craigyjp/Polyphonic-6-note-MIDI-to-CV/Schematic_MIDI-CV_2021-04-22.pdf

# Teensy 3.6

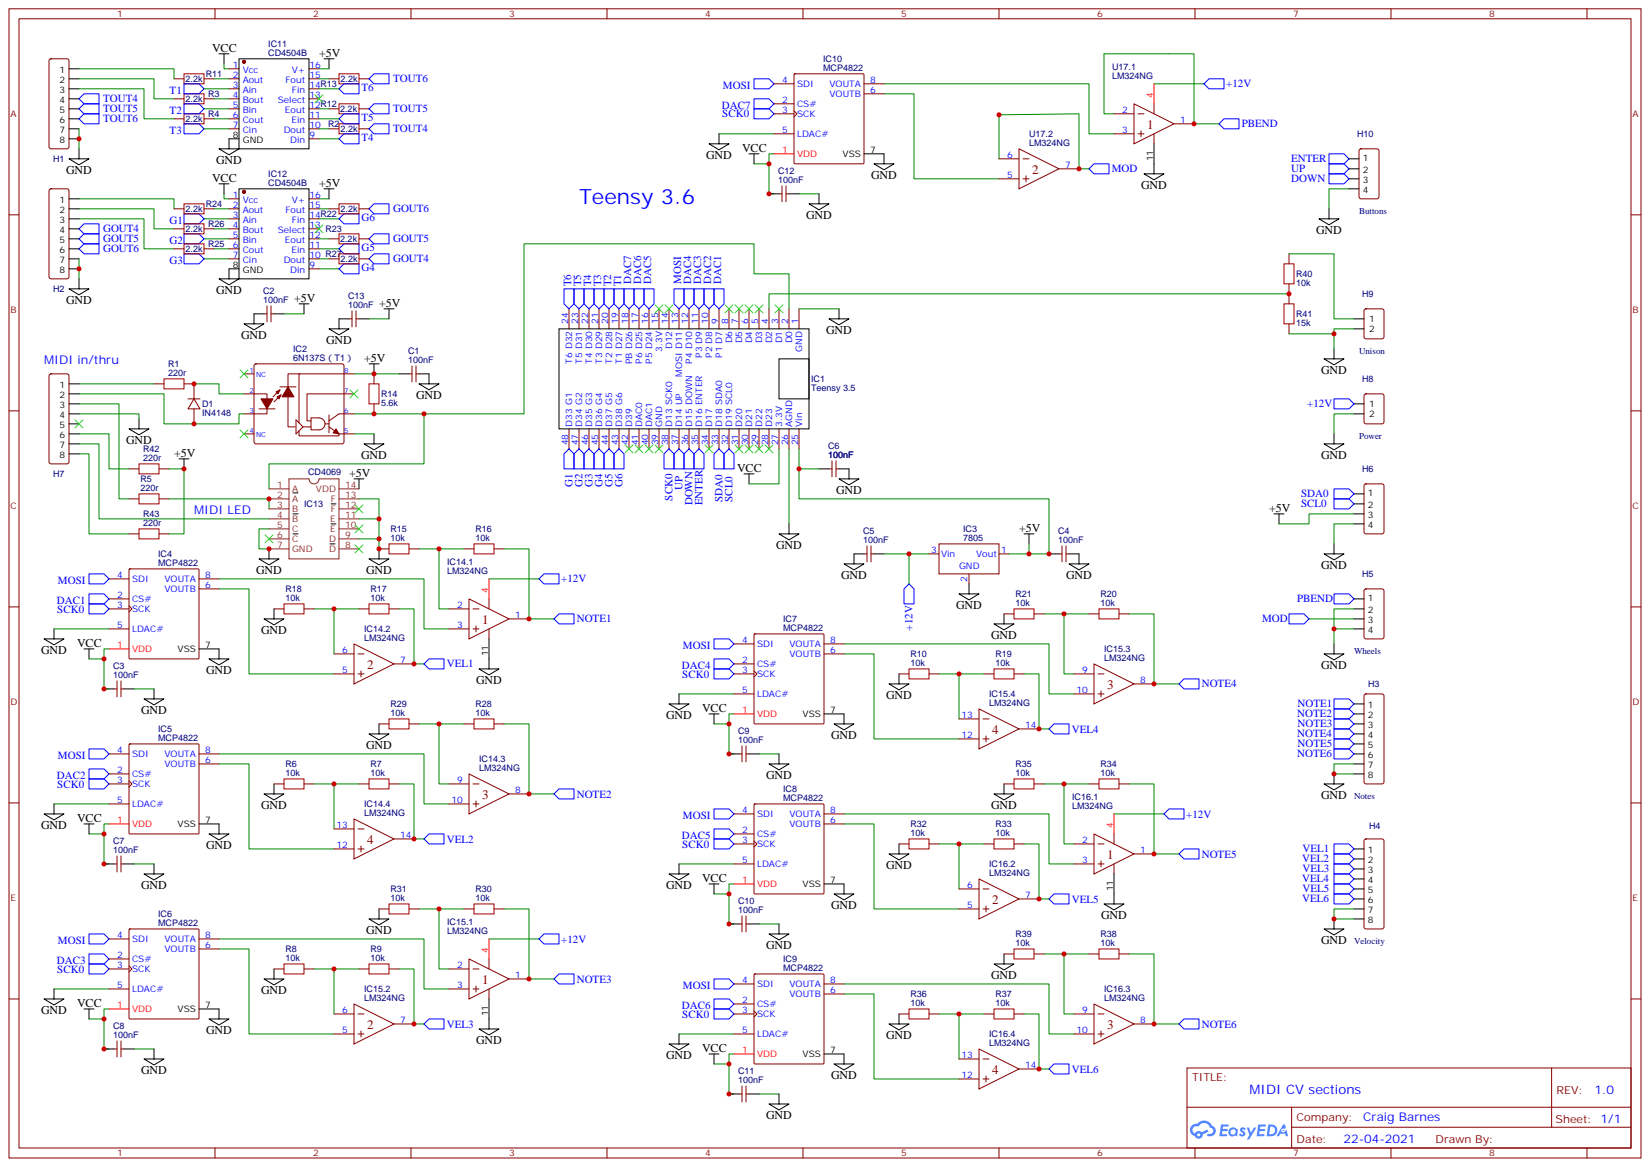
[picture p1: page 1]

Dout 10 Ein 11 Eout 12 Select 13 Fin 14 Fout 15 V+ 16

Vin 25 AGND 26 3.3V 27 D23 28 D22 29 D21 30 D20 31 D19 SCL0 32 D18 SDA0 33 D17 34 D16 ENTER 35 D15 DOWN 36 D14 UP 37 D13 SCK0 38 GND 39 DAC1 40 DAC0 41 D39 42 D38 G6 43 D37 G5 44 D36 G4 45 D35 G3 46 D34 G2 47 D33 G1 48
