craigyjp/Polyphonic-6-note-MIDI-to-CV/(commit log)

2020-04-20 Add files via upload
    Fixed the menus and added a transpose function. Broke out the note scaling backing into 6 individual scales in case your DACs are not perfect.
    [6_note_MIDI_CV_poly.ino]
2020-04-22 Update 6_note_MIDI_CV_poly.ino
    fixed bug with note 6 not having correct CV
    [6_note_MIDI_CV_poly.ino]
2020-04-22 Update README.md
    Added more functionality and removed the encoder in favour of buttons
2020-04-22 Add files via upload
    Additional menu option and encoder replaced with buttons
    [6_note_MIDI_CV_poly.ino]
2020-05-06 Add files via upload
    Fixed missing triggers for MONO and UNISON modes
    Scaled velocity outputs to 0-5V after level converters from 0-4V to give greater range over dynamics.
    [6_note_MIDI_CV_poly.ino]
2021-01-22 Add files via upload
    Added USBMidi support and upgraded to Teensy 3.6
2021-01-23 Add files via upload
    Updated display clk and data pins and added ground for LM324
2021-05-03 Add files via upload
    Added unision button input and deboubced the select buttons
2021-08-01 Add files via upload
    Fixed the unison switching mode
    Fixed a menu issue with the scale factor
    [6_note_MIDI_CV_poly.ino]
